oonchulip97/dribbler/molds/DribblerCylindrical/DribblerCylindricalMold2.sldprt

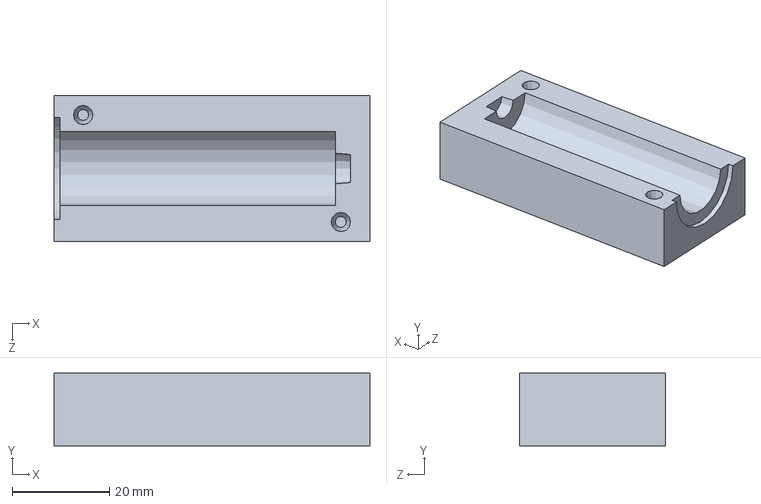
[picture p10: CAD file, 2018-08-29]
molds/DribblerCylindrical/DribblerCylindricalMold2.sldprt
65.0 x 15.0 x 30.0 mm
