oonchulip97/dribbler/molds/DribblerFormulation1/DribblerFormulation1.SLDPRT

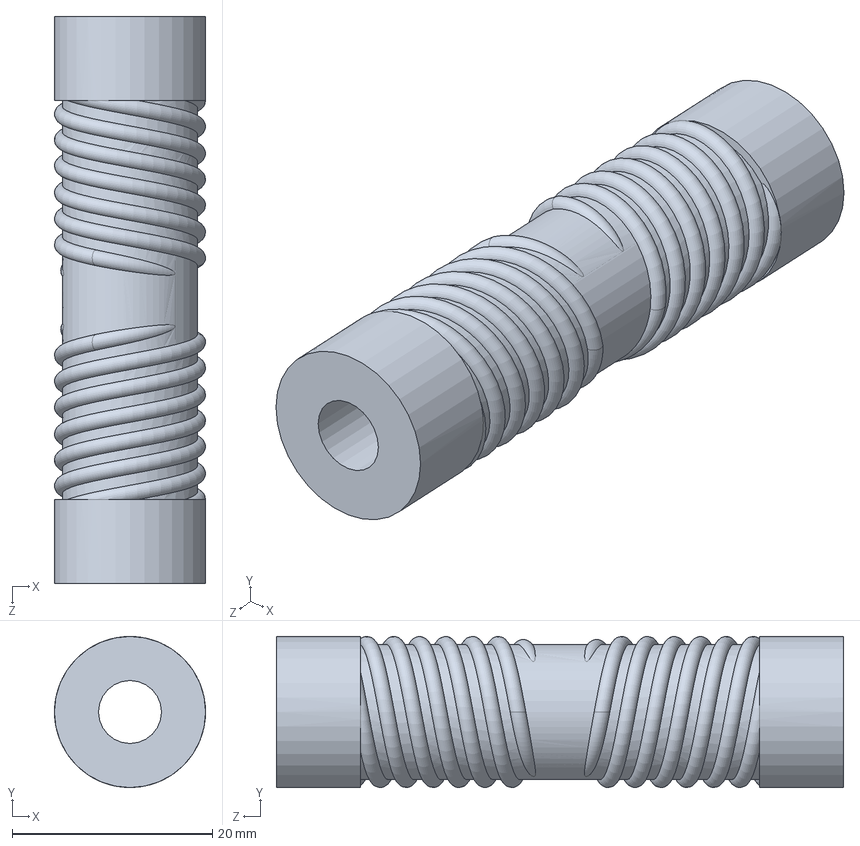
[picture p11: CAD file, 2018-08-29]
molds/DribblerFormulation1/DribblerFormulation1.SLDPRT
15.1 x 15.1 x 56.7 mm
