oonchulip97/dribbler/molds/DribblerFormulation2/DribblerFormulation2Mold2.sldprt

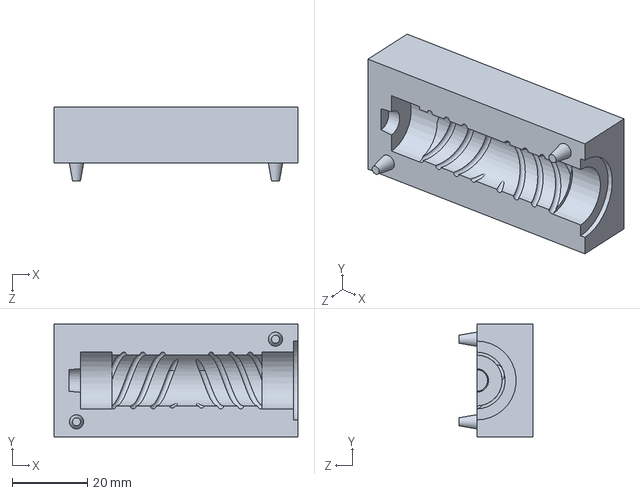
[picture p12: CAD file, 2018-08-29]
molds/DribblerFormulation2/DribblerFormulation2Mold2.sldprt
65.0 x 30.0 x 19.8 mm
