oonchulip97/dribbler/molds/DribblerFormulation3/DribblerFormulation3.SLDPRT

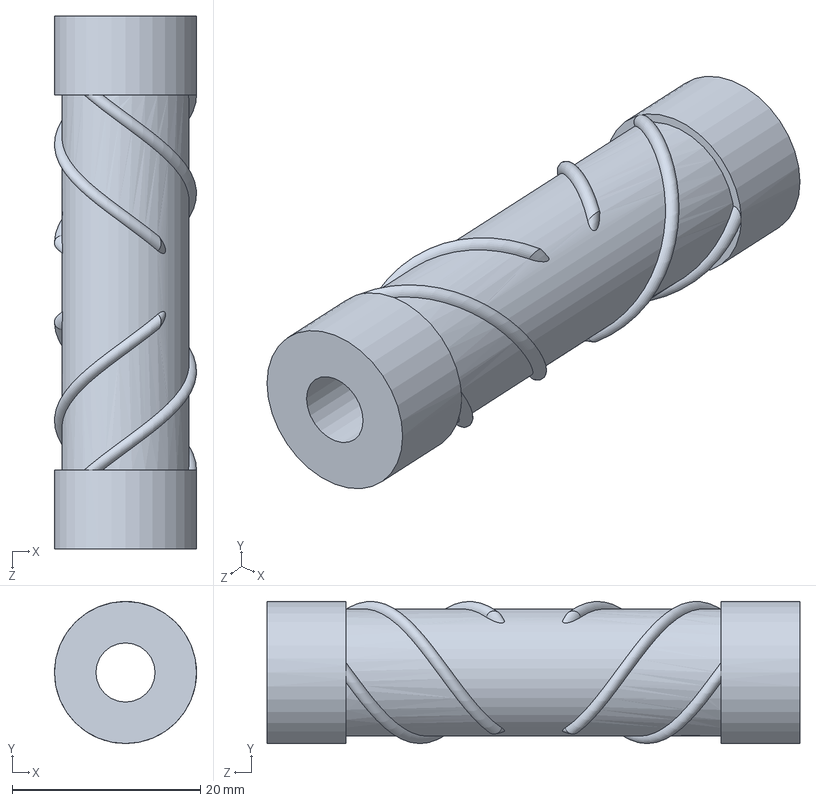
[picture p13: CAD file, 2018-08-29]
molds/DribblerFormulation3/DribblerFormulation3.SLDPRT
15.1 x 15.1 x 56.7 mm
