oonchulip97/dribbler/molds/DribblerFormulation4/DribblerFormulation4Mold1.sldprt

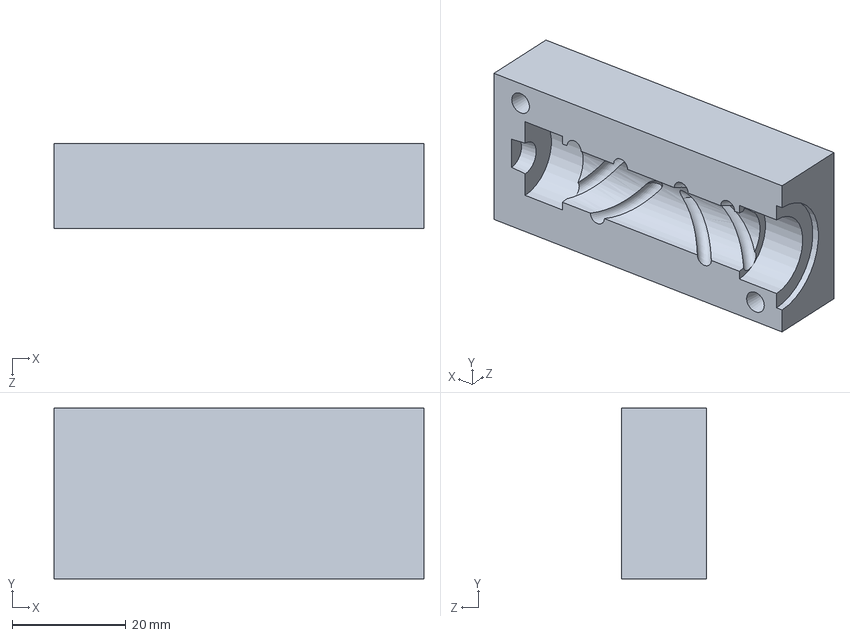
[picture p14: CAD file, 2018-08-29]
molds/DribblerFormulation4/DribblerFormulation4Mold1.sldprt
65.0 x 30.0 x 15.0 mm
