oonchulip97/dribbler/molds/DribblerFormulation5/DribblerFormulation5Mold2.sldprt

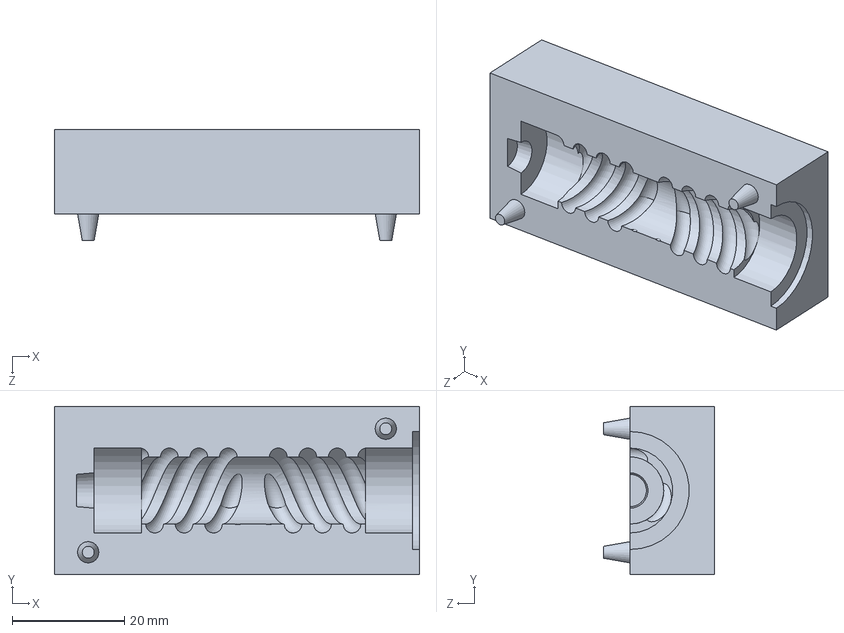
[picture p15: CAD file, 2018-08-29]
molds/DribblerFormulation5/DribblerFormulation5Mold2.sldprt
65.0 x 30.0 x 19.8 mm
