oonchulip97/dribbler/molds/DribblerFormulation6/DribblerFormulation6.SLDPRT

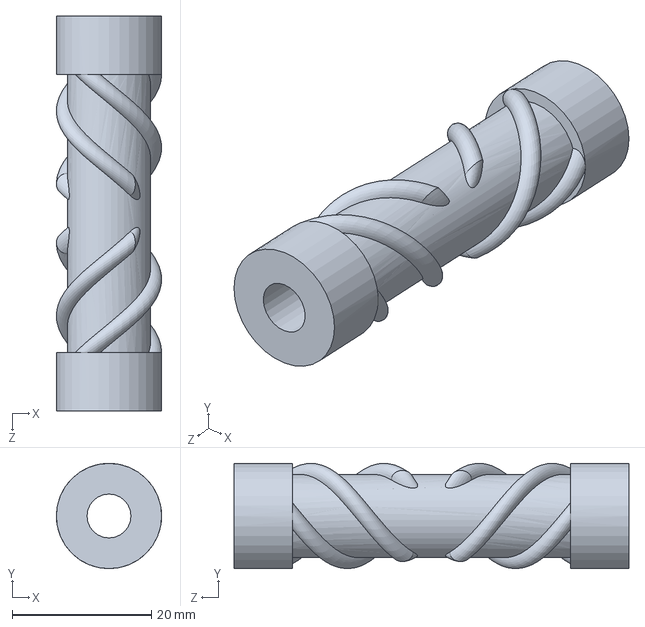
[picture p16: CAD file, 2018-08-29]
molds/DribblerFormulation6/DribblerFormulation6.SLDPRT
15.1 x 15.1 x 56.7 mm
