oonchulip97/dribbler/molds/DribblerIteration3/DribblerIteration3.SLDPRT

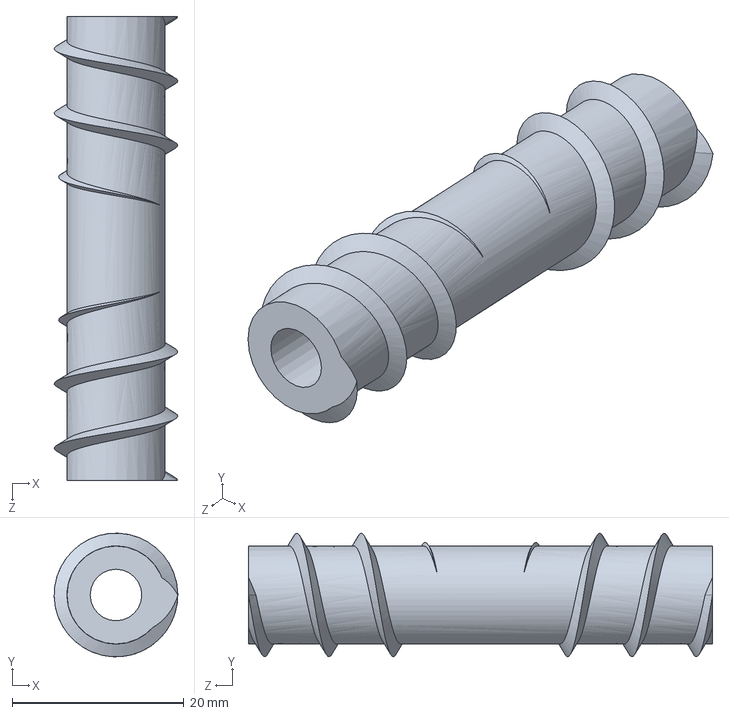
[picture p17: CAD file, 2018-08-29]
molds/DribblerIteration3/DribblerIteration3.SLDPRT
14.4 x 14.4 x 54.0 mm
