oonchulip97/dribbler/molds/DribblerFormulation3/DribblerFormulation3Mold1.SLDPRT

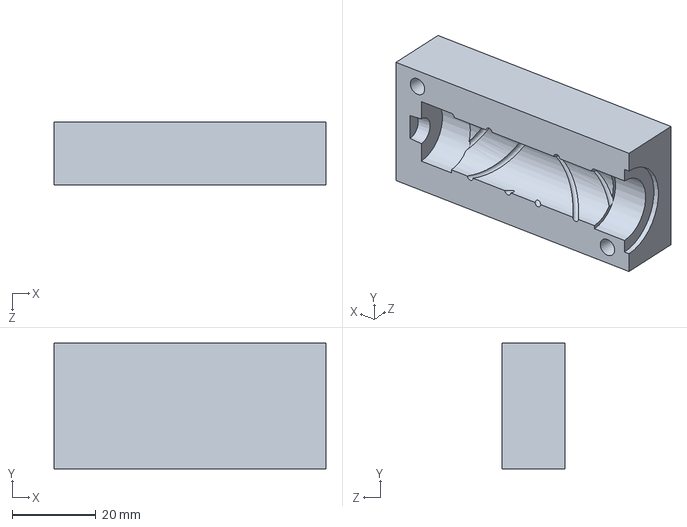
[picture p18: CAD file, 2018-08-29]
molds/DribblerFormulation3/DribblerFormulation3Mold1.SLDPRT
65.0 x 30.0 x 15.0 mm
