oonchulip97/dribbler/molds/DribblerFormulation5/DribblerFormulation5Mold1.sldprt

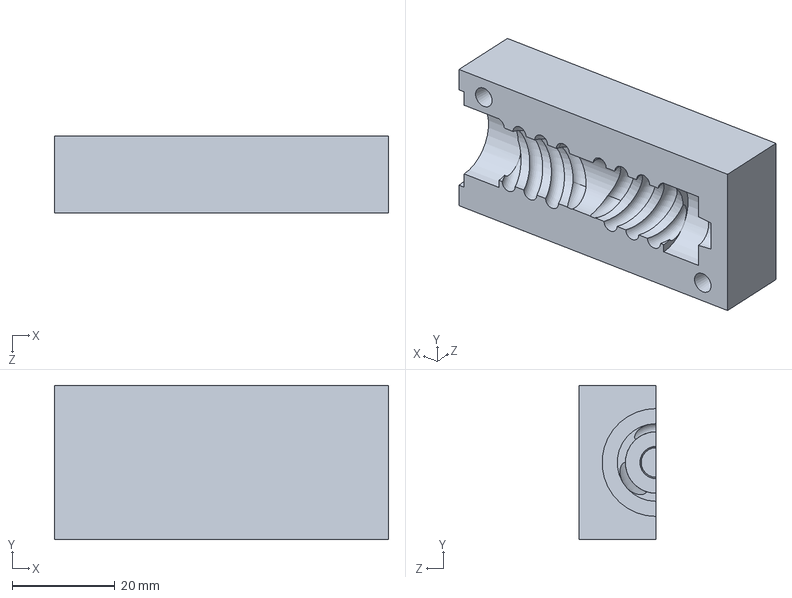
[picture p19: CAD file, 2018-08-29]
molds/DribblerFormulation5/DribblerFormulation5Mold1.sldprt
65.0 x 30.0 x 15.0 mm
