oonchulip97/dribbler/molds/DribblerIteration3/DribblerIteration3Mold1.sldprt

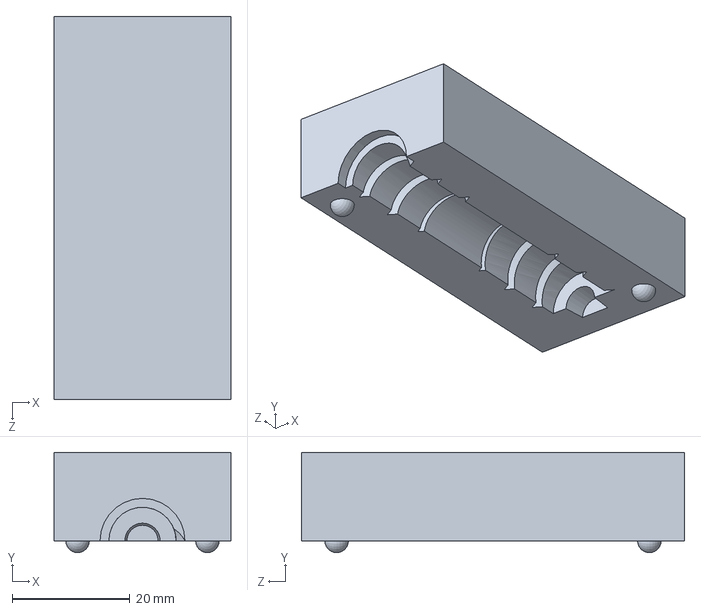
[picture p20: CAD file, 2018-08-29]
molds/DribblerIteration3/DribblerIteration3Mold1.sldprt
30.0 x 17.0 x 65.0 mm
