oonchulip97/dribbler/molds/DribblerCylindrical/DribblerCylindricalMold1.sldprt

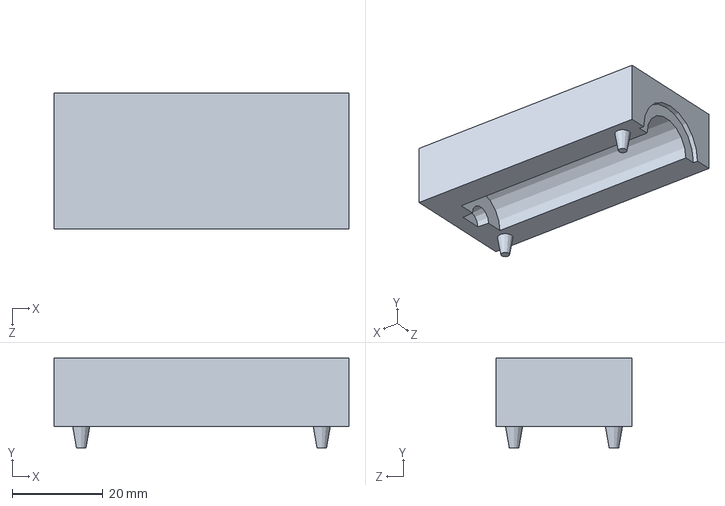
[picture p21: CAD file, 2018-08-29]
molds/DribblerCylindrical/DribblerCylindricalMold1.sldprt
65.0 x 19.8 x 30.0 mm
