oonchulip97/dribbler/molds/DribblerFormulation2/DribblerFormulation2.SLDPRT

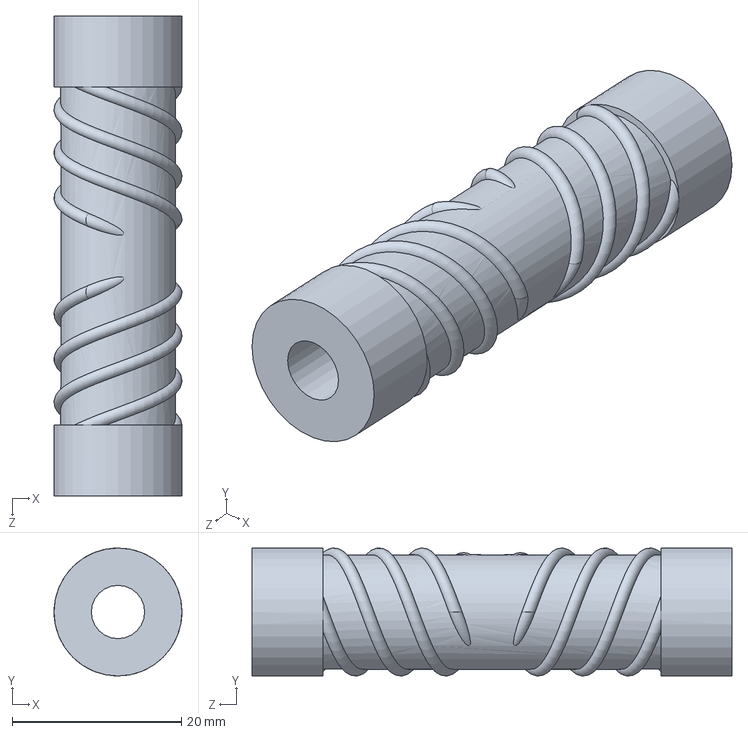
[picture p22: CAD file, 2018-08-29]
molds/DribblerFormulation2/DribblerFormulation2.SLDPRT
15.1 x 15.1 x 56.7 mm
