oonchulip97/dribbler/molds/DribblerFormulation3/DribblerFormulation3Mold2.SLDPRT

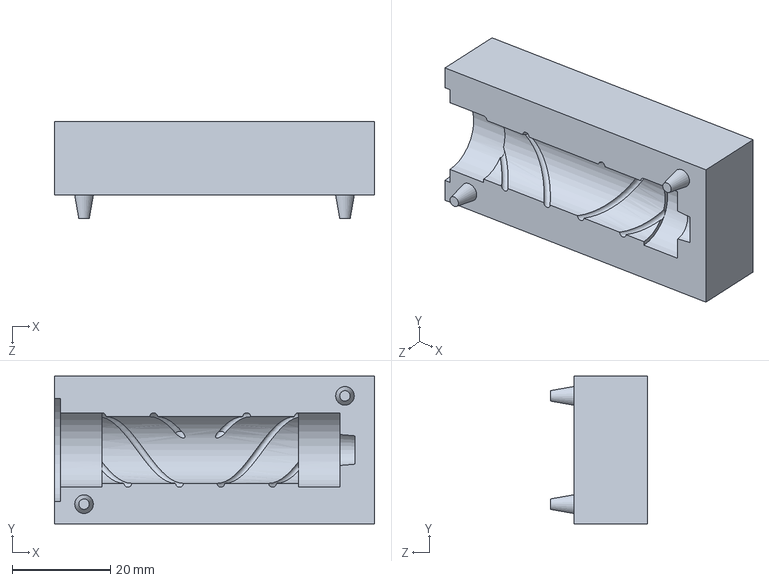
[picture p23: CAD file, 2018-08-29]
molds/DribblerFormulation3/DribblerFormulation3Mold2.SLDPRT
65.0 x 30.0 x 19.8 mm
