oonchulip97/dribbler/molds/DribblerFormulation5/DribblerFormulation5.SLDPRT

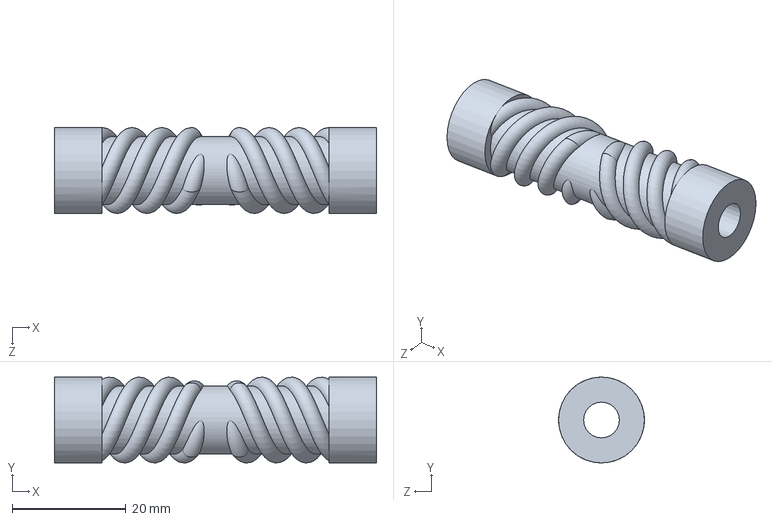
[picture p24: CAD file, 2018-08-29]
molds/DribblerFormulation5/DribblerFormulation5.SLDPRT
56.7 x 15.1 x 15.1 mm
