oonchulip97/dribbler/(list of files, cad)

Other CAD files:
molds/DribblerCylindrical/DribblerCylindrical.SLDPRT
molds/DribblerFormulation1/DribblerFormulation1Mold1.SLDPRT
molds/DribblerFormulation2/DribblerFormulation2Mold1.sldprt
molds/DribblerFormulation4/DribblerFormulation4Mold2.sldprt
molds/DribblerFormulation1/DribblerFormulation1Mold2.SLDPRT
molds/DribblerFormulation6/DribblerFormulation6Mold2.sldprt
molds/DribblerIteration3/DribblerIteration3Mold2.sldprt
molds/DribblerIteration1/DribblerIteration1.SLDPRT
molds/DribblerIteration1/DribblerIteration1Mold1.sldprt
molds/DribblerIteration1/DribblerIteration1Mold2.sldprt
molds/DribblerIteration2/DribblerIteration2.SLDPRT
molds/DribblerIteration2/DribblerIteration2Mold1.sldprt
molds/DribblerIteration2/DribblerIteration2Mold2.sldprt
